HenrickRamalho/Holonomic-Robot-Swarm-Agent/Engine Speed Controller Design/Gráficos de Sintonia Controlador de Velocidade.xlsx

Sheet: Plan1
0
63
105
100
91
90
94
96
97
96
95
98 | float Kp = 0.95; //Ganho Proporcional
98 | float Ki = 0.35; //Ganho Integral
99
99
99
99
98
99
100
101
99
99
98
99
101
101
100
101
99
98
71
34
6
0
0
0
0
0
0
0
59
103
98
89
88
91
93
96
97
97
96
97
97
98
99
100
100
99
98
98
98
100
102
99
99
99
99
100
101
100
84
44
13
0
0
0
0
0
0
0
4
75
110
102
94
93
97
98
97
97
97
100
100
100
99
98
99
99
99
101
100
101
98
99
100
101
100
101
100
100
90
50
18
0
0
0
0
0
0
0
0
68
112
104
93
91
95
97
98
97
98
99
98
98
98
100
101
100
99
98
99
99
100
102
100
100
99
98
100
101
97
63
28
3
0
0

Sheet: Plan2
0
0
0
0
0
0
0
87
118
91
76
86
94
93
91 | float Kp = 1.50; //Ganho Proporcional
93 | float Ki = 0.35; //Ganho Integral
95
95
95
96
98
98
98
97
97
98
98
100
100
99
98
98
98
100
101
100
100
83
43
12
0
0
0
0
0
0
0
0
112
138
97
77
89
99
95
91
94
98
98
96
96
97
97
98
99
99
99
98
99
99
99
100
100
99
99
99
99
92
54
22
0
0
0
0
0
0
0
0
103
127
92
78
88
97
95
92
94
96
97
95
96
98
99
98
98
98
97
99
100
101
99
98
99
98
100
101
99
97
63
28
4
0
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
