HenrickRamalho/Holonomic-Robot-Swarm-Agent/Stl Files for 3d Printing/Travas Motores.stl

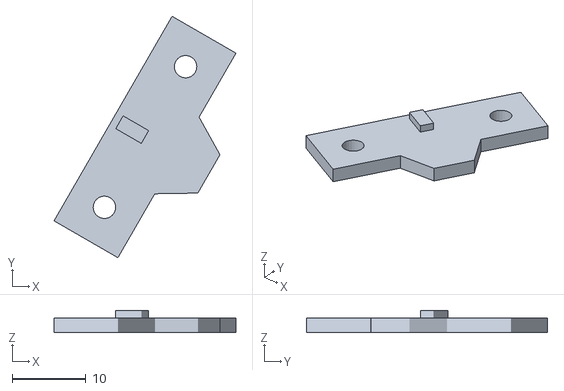
[picture p1: CAD file, 2020-04-10]
Stl Files for 3d Printing/Travas Motores.stl
24.7 x 32.7 x 3.00
