HenrickRamalho/Holonomic-Robot-Swarm-Agent/triangle_description/mesh/rim.stl

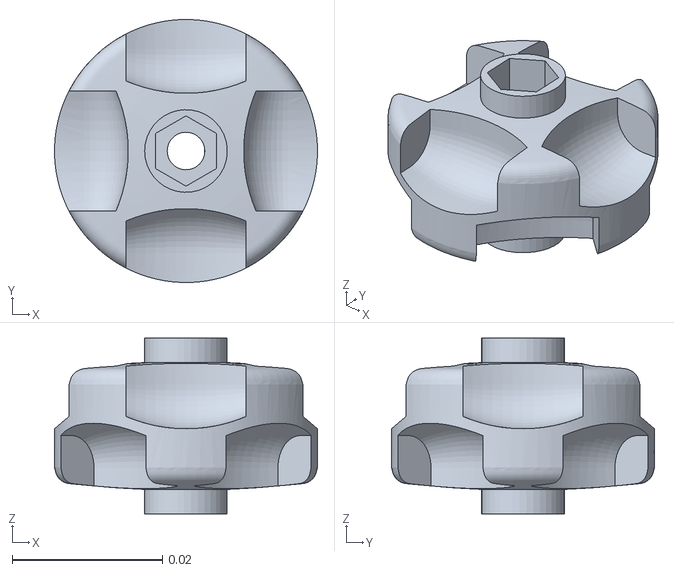
[picture p2: CAD file, 2020-03-14]
triangle_description/mesh/rim.stl
0.035 x 0.035 x 0.0234
