HenrickRamalho/Holonomic-Robot-Swarm-Agent/triangle_description/mesh/roller.stl

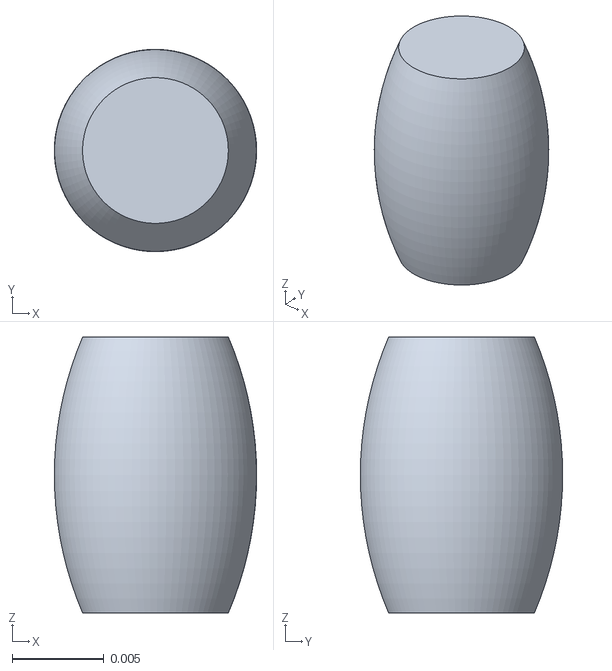
[picture p3: CAD file, 2020-03-14]
triangle_description/mesh/roller.stl
0.011 x 0.011 x 0.015
