HenrickRamalho/Holonomic-Robot-Swarm-Agent/Stl Files for 3d Printing/Acopladores Motor Roda.stl

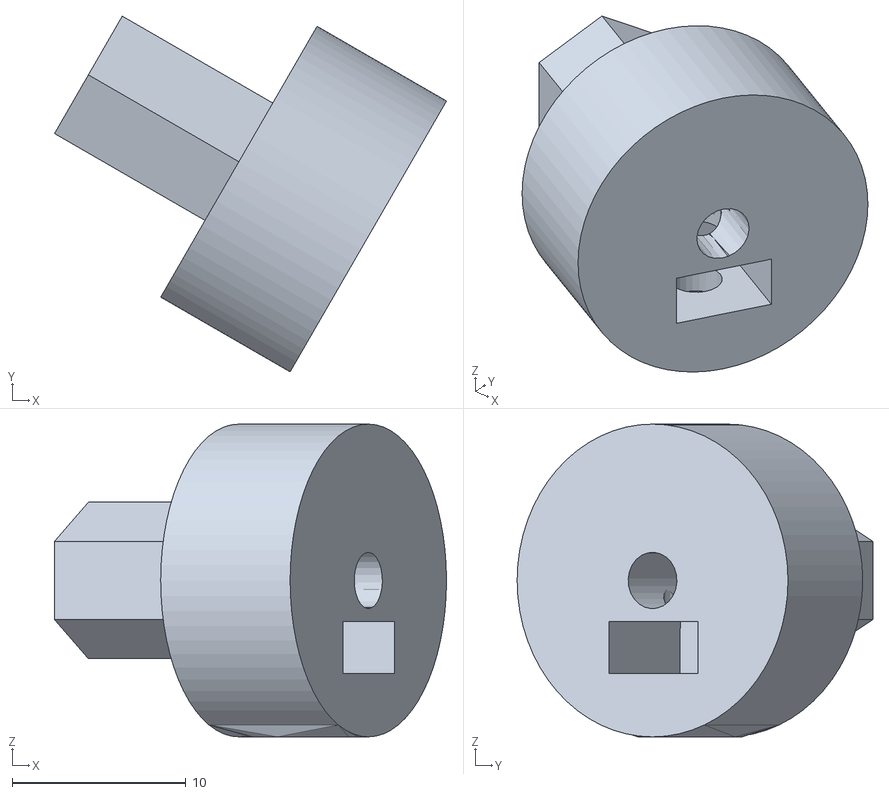
[picture p4: CAD file, 2020-04-10]
Stl Files for 3d Printing/Acopladores Motor Roda.stl
22.6 x 20.5 x 18.0
