HenrickRamalho/Holonomic-Robot-Swarm-Agent/triangle_description/mesh/base.stl

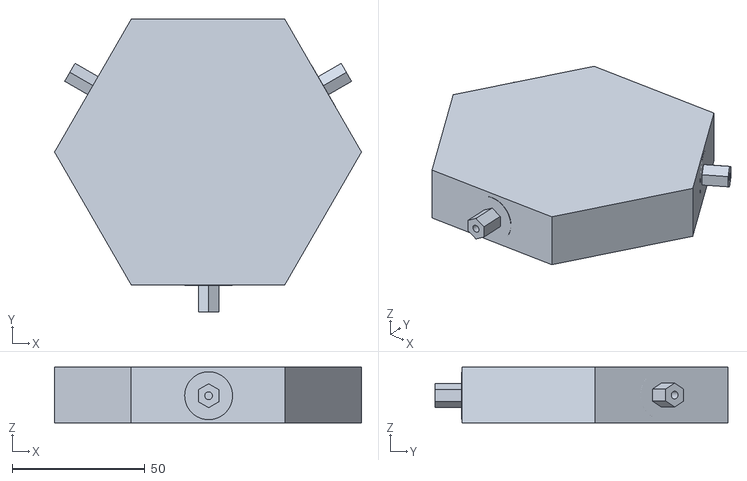
[picture p5: CAD file, 2020-03-14]
triangle_description/mesh/base.stl
115.5 x 110.1 x 21.0
