HenrickRamalho/Holonomic-Robot-Swarm-Agent/Stl Files for 3d Printing/Chassi Camera.stl

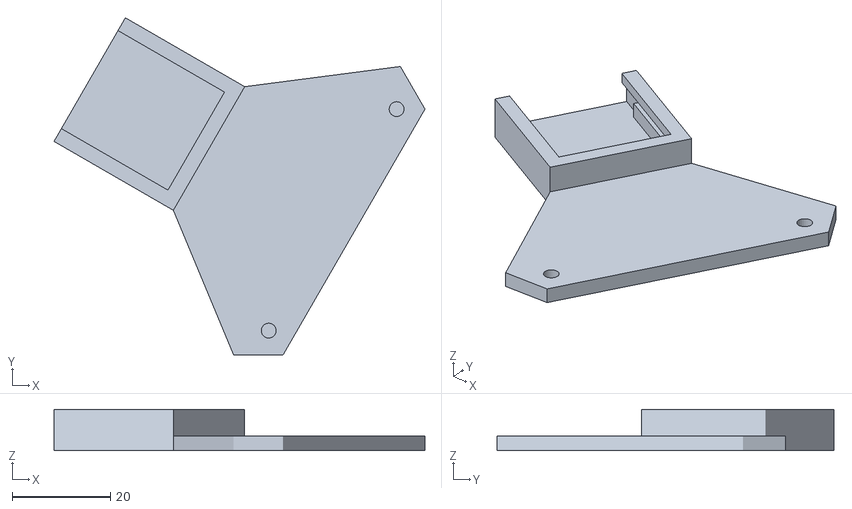
[picture p6: CAD file, 2020-04-10]
Stl Files for 3d Printing/Chassi Camera.stl
75.4 x 68.6 x 8.40
