HenrickRamalho/Holonomic-Robot-Swarm-Agent/Stl Files for 3d Printing/Chassi Motores.stl

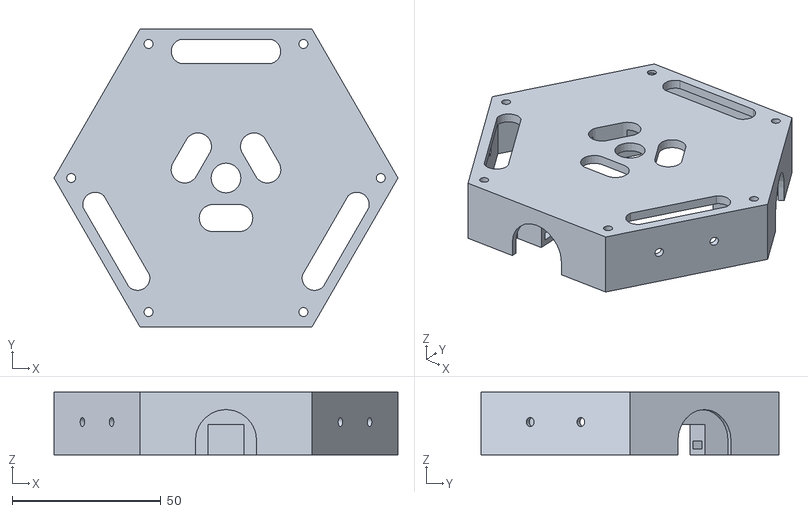
[picture p7: CAD file, 2020-04-10]
Stl Files for 3d Printing/Chassi Motores.stl
115.5 x 100.0 x 21.0
