HenrickRamalho/Holonomic-Robot-Swarm-Agent/Stl Files for 3d Printing/Chassi RaspberryPi.stl

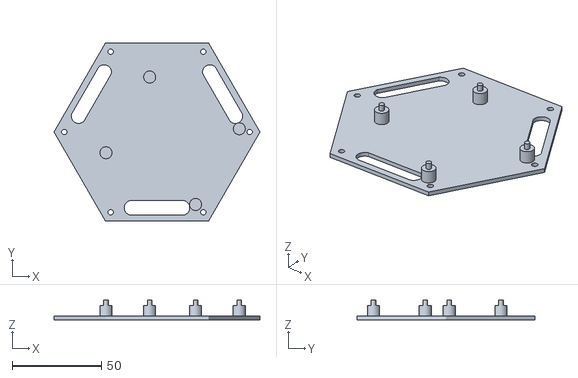
[picture p8: CAD file, 2020-04-10]
Stl Files for 3d Printing/Chassi RaspberryPi.stl
115.5 x 100.0 x 11.0
