HenrickRamalho/Holonomic-Robot-Swarm-Agent/(list of files, cad)

Other CAD files:
Stl Files for 3d Printing/Chassi Fonte.stl
