HenrickRamalho/Holonomic-Robot-Swarm-Agent/Engine Speed Controller Design/Speed_Controll_PCB.brd

## EAGLE design Engine Speed Controller Design/Speed_Controll_PCB.brd (2019-11-26)

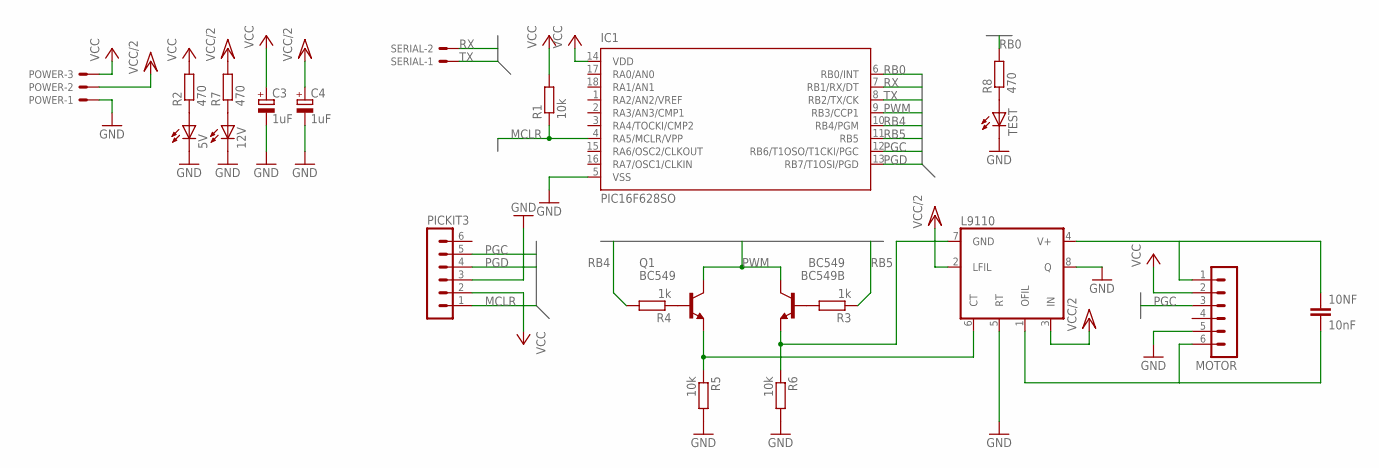
[picture p9: schematic Speed_Controll_PCB.sch]

Parts:
5V, 12V: LEDCHIPLED_1206; CHIPLED_1206
10NF: 10nF; C0603K
BC549: BC549B; TO92-EBC
C3, C4: 1uF; 153CLV-0405
IC1: PIC16F628SO; SO-18W
L9110: LM567D; SO08
MOTOR: MA06-1
PICKIT3: MA06-1
POWER: JST-XH-03-PIN-LONG-PAD; JST-XH-03-PACKAGE-LONG-PAD
Q1: BC549; TO92-EBC
R1, R5, R6: 10k; MINI_MELF-0102W
R2, R7, R8: 470; MINI_MELF-0102W
R3, R4: 1k; MINI_MELF-0102W
SERIAL: JST-XH-02-PIN-LONG-PAD; JST-XH-02-PACKAGE-LONG-PAD
TEST: LEDCHIPLED_1206; CHIPLED_1206

Connections:
GND: 5V.C, 12V.C, C3.-, C4.-, IC1.5 (VSS), L9110.5 (RT), L9110.8 (Q), MOTOR.5, PICKIT3.3, POWER.1, R5.2, R6.2, TEST.C
MCLR: IC1.4 (RA5/MCLR/VPP), PICKIT3.1, R1.1
unnamed: 10NF.1, L9110.4 (V+), MOTOR.1
unnamed: 5V.A, R2.1
unnamed: BC549.E, L9110.7 (GND), R6.1
unnamed: 10NF.2, L9110.1 (OFIL), MOTOR.6
unnamed: BC549.B, R3.2
unnamed: Q1.B, R4.1
unnamed: 12V.A, R7.1
unnamed: R8.1, TEST.A
unnamed: L9110.6 (CT), Q1.E, R5.1
PGC: IC1.12 (RB6/T1OSO/T1CKI/PGC), MOTOR.3, PICKIT3.5
PGD: IC1.13 (RB7/T1OSI/PGD), PICKIT3.4
PWM: BC549.C, IC1.9 (RB3/CCP1), Q1.C
RB0: IC1.6 (RB0/INT), R8.2
RB4: IC1.10 (RB4/PGM), R4.2
RB5: IC1.11 (RB5), R3.1
RX: IC1.7 (RB1/RX/DT), SERIAL.2
TX: IC1.8 (RB2/TX/CK), SERIAL.1
VCC: C3.+, IC1.14 (VDD), MOTOR.2, PICKIT3.2, POWER.3, R1.2, R2.2
VCC/2: C4.+, L9110.2 (LFIL), L9110.3 (IN), POWER.2, R7.2

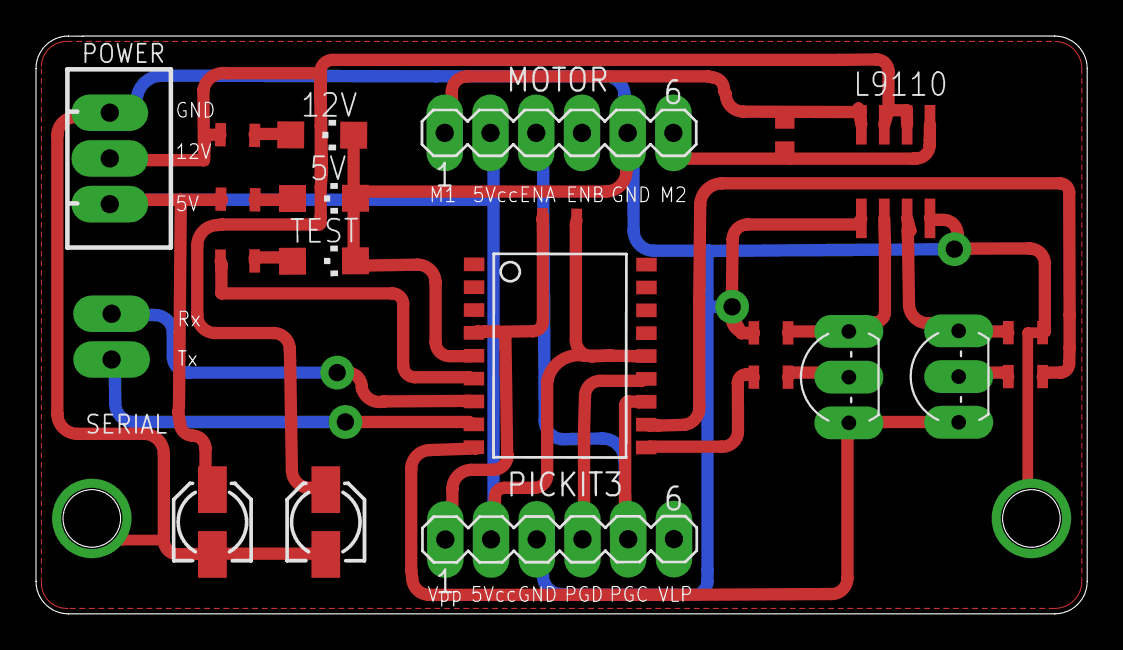
[picture p10: board Speed_Controll_PCB.brd from above]

Board: 2 copper layers, 58.4 x 32.1 mm, 22 parts (1 on the bottom side), 21 nets.
