HenrickRamalho/Holonomic-Robot-Swarm-Agent/Stl Files for 3d Printing/Robot.png

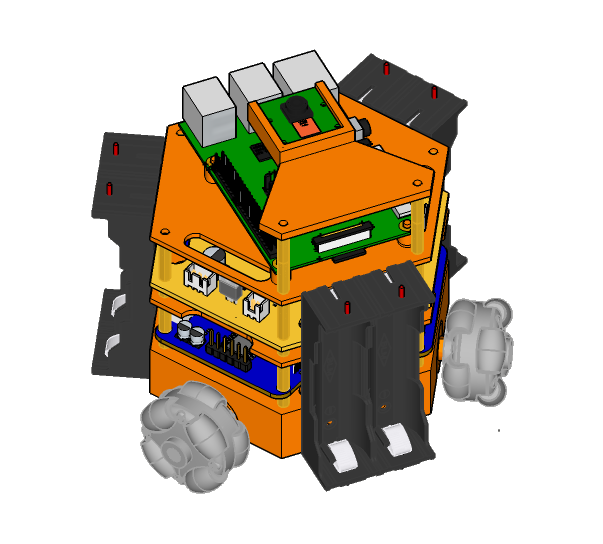
Stl Files for 3d Printing/Robot.png
