HenrickRamalho/Holonomic-Robot-Swarm-Agent/(threads)

Thread 2 (2020-02-05):

Fornecer modelo URDF do robô

hjudiss, 2020-02-05:
Talvez usando isso:
http://wiki.ros.org/Industrial/Tutorials/Create%20a%20URDF%20for%20an%20Industrial%20Robot

hjudiss, 2020-02-05:
O modelo pode ser feito ap3roveitando os arquivos STL que o @HenrickRamalho já disponibilizou. Faltariam ainda arquivos 3D de outros itens, principalmente a roda.
Também achei o seguinte repositório em que podemos no basear.
https://github.com/GuiRitter/OpenBase
@HenrickRamalho você poderia confirmar se o modelo da roda é equivalente?

HenrickRamalho, 2020-02-06:
Sim professor, esse modelo da roda é igual.

Em qua, 5 de fev de 2020 20:01, Heitor Savino <notifications@github.com>
escreveu:

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

hjudiss, 2020-02-06:
ótimo, vou criar um esqueleto de um pacote a partir dele entao.
Você poderia olhar os outros itens que marquei em
https://github.com/HenrickRamalho/Holonomic-Robot-Swarm-Agent/issues/2#issuecomment-582654639
?

hjudiss, 2020-02-26:
você poderia carregar os .stf na pasta: https://github.com/HenrickRamalho/Holonomic-Robot-Swarm-Agent/tree/master/Stl%20Files%20for%203d%20Printing?

hjudiss, 2020-04-09:
@HenrickRamalho você pode me enviar ou carregar os arquivos stl separadamente de cada parte que voce usou para montar o robô completo?

hjudiss, 2020-05-04:
@HenrickRamalho qual a altura das hastes que separam as placas na vertical? tem uma baixinha e outras maiores, certo? quais as medidas?

Thread 3 (2020-02-05):

Carregar o modelo em Gazebo com as interfaces de controle

hjudiss, 2020-02-05:

hjudiss, 2020-02-26:
Estou cuidando desta parte. Vou precisar que o robô tenha as interfaces de velocidade funcionando para que o sistema seja transparente entre simulação e o robô real.

Closed 2020-04-23.

Thread 5 (2020-03-11):

Separação de tarefas entre os agentes

HenrickRamalho, 2020-03-11:
Desenvolvi um arquivo launch para realizar a separação de tarefas entre os robôs, agora as câmeras estão trabalhando de forma individual; a imagem a seguir mostra o arquivo de launch do robô master na rede:

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

a seguir temos o arquivo de launch do robô escravo:

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

o rqt_graph de execução do ROS:

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

as câmeras acionadas no hardware:

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

Agora vamos para os problemas:
                   *Aparentemente a localização parou de funcionar, o rviz fica alternando entre as
                    câmeras dos robôs;
                   *A mensagem de localização gerada pelo Slam agora é essa:

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

Acredito que quando for sanado este problema, os robôs poderão executar suas tarefas em conjunto.

hjudiss, 2020-03-11:
Eu acredito que ainda deve haver um fiducial_slam pra cada robô.
Os dois agentes estão enviando dados para esse nó num mesmo tópico

HenrickRamalho, 2020-03-11:
Fiz a modificação do Slam, mas o tópico Fiducial_transforms também precisa ser modificado, pois o mesmo esta sendo enviado pelo robo02 (slave) para o slam do robo01 (master).

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

hjudiss, 2020-03-11:
você pode renomear os tópicos com qualquer nome. Mas o padrão seria incluir também o namespace no tópico.

HenrickRamalho, 2020-03-11:
Certo, estou testando se o fiducial_transforms pode ser alterado por um argumento.

hjudiss, 2020-03-12:
quando você faz o launch você pode colocar ele em um namespace, assim como
os tópicos

On Thu, Mar 12, 2020 at 12:25 AM HenrickRamalho <notifications@github.com>
wrote:

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

--
Heitor J. Savino

hjudiss, 2020-04-03:
@HenrickRamalho você conseguiu resolver isso?

Thread 6 (2020-04-09):

detalhes de materiais

hjudiss, 2020-04-09:
Olá @HenrickRamalho

qual o material usado para imprimir as partes?
estou especificamente interessado no peso e nas densidades

hjudiss, 2020-04-09:
@HenrickRamalho
você tem como pesar a base do robô pra mim junto com os motores e controladores?

HenrickRamalho, 2020-04-09:
Tenho sim

Em qui, 9 de abr de 2020 10:43, Heitor Savino <notifications@github.com>
escreveu:

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

HenrickRamalho, 2020-04-09:
Ele tem 623 gramas, completo.

Em qui, 9 de abr de 2020 10:43, Henrick Ramalho <henrickviana@gmail.com>
escreveu:

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

hjudiss, 2020-04-09:
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
essa parte sem a roda dá 623?

HenrickRamalho, 2020-04-09:
Não, esse era o peso total, do robô inteiro, vou fazer a leitura novamente.

Em qui, 9 de abr de 2020 11:01, Heitor Savino <notifications@github.com>
escreveu:

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

HenrickRamalho, 2020-04-10:
Olá professor, o peso medido da parte inferior do robô incluindo:
- Chassi Inferior (Onde os motores são fixados);
- 3 Travas para os motores;
- 3 Acopladores Motor/Roda;
- 3 Motores com Encoder;
- 3 Placas de Controle de Velocidade;
- 3 Cabos 6 vias que ligam Motor/Controlador;
- 6 parafusos e porcas;
Foi igual a 135 gramas.

Thread 7 (2020-04-23):

Sugestões de capítulos e seções

hjudiss, 2020-04-23:
Podemos sugerir aqui a sequencia do trabalho de dissertação:
Na qualificação havia:

1. INTRODUÇÃO
2. FUNDAMENTAÇÃO TEÓRICA
2.1 Robôs Omnidirecionais
2.2 Controle Preditivo
2.3 Particle Swarm Optimization
3 OBJETIVOS GERAL E ESPECÍFICO
3.1 Objetivo Geral
3.2 Objetivos Específicos
4. RELEVÂNCIA DA PROPOSTA
5. METODOLOGIA
6. CRONOGRAMA DE ATIVIDADES
REFERÊNCIAS

Posso pensar nas seguintes partes, a desenvolver mais:

1. INTRODUÇÃO
2. FUNDAMENTAÇÃO TEÓRICA
2.1 Robôs Omnidirecionais
2.2 Particle Swarm Optimization
2.3 OBJETIVOS GERAL E ESPECÍFICO
2.4 RELEVÂNCIA DA PROPOSTA
3. PROJETO DE HARDWARE
4. PROJETO DE SOFTWARE
5. SIMULAÇÃO
6. RESULTADOS EXPERIMENTAIS
REFERÊNCIAS

O que sugerem?

erickIC, 2020-04-23:
Sugiro o seguinte:
    1. INTRODUÇÃO
        1.1. Justificativa
        1.2. OBJETIVOS GERAL E ESPECÍFICO
        1.3. RELEVÂNCIA DA PROPOSTA
    2. FUNDAMENTAÇÃO TEÓRICA
        2.1. Robôs Omnidirecionais
        2.2. Enxame de robôs
        2.3. Plataforma de robôs omnidirecionais e para enxame
    3. PROJETO DE HARDWARE
        3.1. Controle das rodas
        3.2. Câmera
        3.3. Controle de velocidade e processamento principal
        3.4. Custo do hardware
    4. INTEGRAÇÃO COM O ROS
    5. SIMULAÇÃO (teve?)
    6. RESULTADOS EXPERIMENTAIS
    7. REFERÊNCIAS

**Justificativa**
- Removi “2.2. Particle Swarm Optimization” pois não terá mais a utilização do PSO
- Coloquei os objetivos e relevância na INTRODUÇÃO pois acho que devem estar logo no começo do texto
- Coloquei duas novas seções da FUNDAMENTAÇÃO TEÓRICA, a 2.3 é importantíssima para destacar as “concorrentes”
- Tentei colocar subseções em PROJETO DE HARDWARE seguindo os “andares” do robô
- Acho melhor colocar INTEGRAÇÃO COM O ROS em vez de PROJETO DE SOFTWARE, chama logo a atenção a isso no sumário
- Não lembro de resultados simulados

hjudiss, 2020-04-23:
De acordo com todas as sugestões.

> * Não lembro de resultados simulados
Vai ser a parte do simulador no Gazebo que estou finalizando. Eu vou me encarregar dessa parte

HenrickRamalho, 2020-04-23:
Muito bom! Estou de acordo.

hjudiss, 2020-04-23:
Adicionei as seções no documento do overleaf. Falta o @HenrickRamalho aceitar o convite enviado ao email: henrickviana@gmail.com

HenrickRamalho, 2020-04-23:
Caraca, mestres Jedis serão meus avaliadores !!!

Em qui., 23 de abr. de 2020 às 18:07, Heitor Savino <
notifications@github.com> escreveu:

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

hjudiss, 2020-04-23:
hahahaha! eu alterei os orientador e coorientador originais, que eram:
\orientador{Obi-Wan Kenobi}	%%Nome
\tituloOrientador{Prof. Dr.}
\coorientador{Darth Vader}%%Nome
\tituloCoorientador{Prof. Dr.}

HenrickRamalho, 2020-04-23:
kkkkkkkkkkk

Em qui., 23 de abr. de 2020 às 18:14, Heitor Savino <
notifications@github.com> escreveu:

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

Closed 2020-04-29.

Thread 8 (2020-04-23):

Sugestão de nome pro robô

hjudiss, 2020-04-23:
@HenrickRamalho , já tem nome pro robô?
Eu queria sugerir Omnino :smiley:
uma mistura de ô menino, com omni, e ainda soa italiano.
Vocês tem outras sugestões?
quando definirmos o nome adicionar a plataforma de simulacao no repositório do EASY

erickIC, 2020-04-23:
Omnino!!!!!
Kkkk
Nome chiclete, todo mundo vai pegar fácil.

Em qui, 23 de abr de 2020 14:42, Heitor Savino <notifications@github.com>
escreveu:

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

HenrickRamalho, 2020-04-23:
Também gostei professor! Está ótimo!

Closed 2020-05-01.

Thread 10 (2020-04-24):

escrita do artigo

hjudiss, 2020-04-24:
posso também dar a seguinte indicação de congresso:

hjudiss, 2020-04-24:
Topics |
Robotics at school
Robotics teachers formation
Robotics competitions
**Educational Robotics Platform**
Robotics in informal teaching (extra class)
Study cases
Methodologies and materials for teaching
Web based Robotics Educational
Robotics Simulation
Robotics in Education curricula
**Low cost educational robots**
Social robotics
Unplugged Robotics
Computational thinking with Educational Robotics
Robot-student interaction
STEM with Robotics based projects
Problem based learning with Robotics
Robot-student interaction
* Please choose between 1 and 3 topics

hjudiss, 2020-04-24:
submissão está aberta e deadline de 15 de junho

hjudiss, 2020-05-04:
Computers and Electrical Engineering
https://www.journals.elsevier.com/computers-and-electrical-engineering/

Journal of Control, Automation and Electrical Systems
https://link.springer.com/journal/40313/volumes-and-issues

Thread 11 (2020-04-30):

Custo

hjudiss, 2020-04-30:
@HenrickRamalho, coloque aqui a lista de custos, por favor.

HenrickRamalho, 2020-04-30:
Para a montagem de um Omnino são necessários os seguintes materiais:

     - 3 rodas omnidirecionais 1,5 pol ou 38mm -  Custo R$76,20
     - 3 motores N20 6Vcc 90RPM com encoder - Custo R$95,82
     - 3 Cases de bateria 18650 2 slots - Custo R$11,31
     - 6 baterias 18650 recarregáveis R$34,70
     - 1 Raspberry Pi 3 Model B+ - Custo R$262,08
     - 1 Raspicam 1080p 720p 5mp - Custo R$21,02
     - Peças impressas em 3D - Custo R$50,00
     - 3 placas de controle de velocidade - Custo R$60,00
     - 1 placa de fonte - Custo R$19,00
     - Parafusos e Porcas - Custo R$15,00
     * Custo total =R$645,13
A maior parte dos valores ficaram mais altos por conta do aumento do dólar.

hjudiss, 2020-05-01:
pode colocar o valor em dólar

hjudiss, 2020-05-01:
>  1 Raspicam 1080p 720p 5mp - Custo R$21,02

camera tem realmente esse preço?

HenrickRamalho, 2020-05-01:
Sim professor!

Em sex, 1 de mai de 2020 18:16, Heitor Savino <notifications@github.com>
escreveu:

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

Thread 12 (2020-04-30):

é possível imprimir a roda? e outros?

hjudiss, 2020-04-30:
@HenrickRamalho a roda você comprou, seria possível imprimir?

favor, listar tudo o que foi comprado e o que pode ser impresso

HenrickRamalho, 2020-04-30:
Sim professor, as rodas foram compradas, mas posso tentar fazer os arquivos de impressão delas.

HenrickRamalho, 2020-04-30:
Também podemos imprimir os packs de baterias, mas eles são tão baratos, por volta de 3 reais, que ficam mais caros se forem impressos em 3D.

hjudiss, 2020-04-30:
> Sim professor, as rodas foram compradas, mas posso tentar fazer os arquivos de impressão delas.

Veja só se tem algum modelo feito já. Se houver você inclui

Closed 2020-04-30.

Thread 13 (2020-04-30):

eletronica

hjudiss, 2020-04-30:
@HenrickRamalho as placas de controle dos motores foram feitas por você também?

Favor identificar tudo o que pode ser fabricado e tudo o que deve ser comprado aqui:

HenrickRamalho, 2020-04-30:
Sim as placas de controle de velocidade e fonte foram desenvolvidas e confeccionadas por mim, mas nos robôs finais mandei a confecção das PCB's de controle para ser executada na China, recebendo as placas vindas da China, tive que somente soldar os componentes e programar o microcontrolador PIC que nela se encontra.

Para a confecção das placas de controle de velocidade são necessários:
     - 3 placas de fenolite dupla face virgem (3,2cm x 5,7cm)
     - 3 microcontroladores PIC16f628A em SMD-SOP
     - 6 Transistores BC549 TO-92
     - 9 Led's SMD 0805
     - 6 capacitores eletrolíticos 10uF 16Vcc SMD
     - 9 resistores 470 Ohm 0805
     - 9 resistores de 10k Ohm 0805
     - 6 resistores de 4,7k Ohm 0805
     - 3 Capacitores Cerâmicos 1nF SMD 0603
     - 3 CI ponte H 9110 SMD
     - 3 conectores Header Macho 6 vias
     - 3 conectores JST Fêmea 6 vias
     - 3 conectores JST Fêmea 3 vias
     - 3 conectores JST Fêmea 2 vias

Placa totalmente feita por mim:
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

Placa confeccionada na China:
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

Placa chinesa com montagem e soldagem minha:
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

hjudiss, 2020-04-30:
Inclua também uma foto do esquemático, se possível. To pensando em como colocar isso na seção de Hardware, talvez o @erickIC saiba melhores formas de descrever a essa parte de hardware.

erickIC, 2020-04-30:
Para descrever o HW coloque o esquemático elétrico e a placa pronta. Além de no texto colocar uma tabela, ou lista, com todos os componentes. Talvez isso possa até ser um apêndice, para não poluir muito o texto.

hjudiss, 2020-05-01:
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
Que tal uma imagem nesse mesmo sentido?

HenrickRamalho, 2020-05-01:
Achei muito boa professor!
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

hjudiss, 2020-05-01:
A bateria é de apenas 400mAh?
A rede de comunicação já é fornecida na própria Raspberry?

HenrickRamalho, 2020-05-01:
No desenho cometi um erro, as baterias tem 980mah, e a comunicação é feita pela rede gerada pelo próprio raspberry, eles se comunicam por wifi.

Segue o desenho atualizado:
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

HenrickRamalho, 2020-05-01:
Fiz este com a indicação da comunicação wifi:
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

hjudiss, 2020-05-01:
Coloca Video Stream em vez de Localization

Em sex., 1 de mai. de 2020 às 16:49, HenrickRamalho <
notifications@github.com> escreveu:

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

--
Heitor J. Savino

HenrickRamalho, 2020-05-01:
Modificação feita!

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

hjudiss, 2020-05-01:
de qualquer forma, o esquemático que você mostrou anteriormente vai entrar
na dissertação. No artigo vamos limitar a esse mais simples.

Faz uma versão alternativa:
remove o título Omnino Hardware Diagram, pois eu posso colocar isso na
leganda da figura.
Tira o contorno e coloca o fundo branco, ou transparente (se possível).

Em sex., 1 de mai. de 2020 às 17:21, HenrickRamalho <
notifications@github.com> escreveu:

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

--
Heitor J. Savino

HenrickRamalho, 2020-05-01:
Não tenho certeza se o fundo ficou transparente, segue o aquivo:
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

HenrickRamalho, 2020-05-01:
Acho que ficou!

hjudiss, 2020-05-01:
ficou boa.
ainda acho 980mAh muito pouco comparado com outras que eu vi

HenrickRamalho, 2020-05-01:
verdade, posso ver baterias melhores para o projeto, essas baterias são bem fraquinhas, pois seu custo é muito baixo,

erickIC, 2020-05-04:
Ficou bom!

Em sex., 1 de mai. de 2020 às 17:16, HenrickRamalho <
notifications@github.com> escreveu:

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

--

[image: Universidade Federal de Alagoas] <http://www.ufal.br/>

Erick de Andrade Barboza / Professor Dr.
Lattes <http://lattes.cnpq.br/1049532071774598>

Universidade Federal de Alagoas
Instituto de Computação - IC
www.ufal.br

[image: Twitter]  <https://www.twitter.com/ufaloficial> [image: Facebook]
<https://www.facebook.com/ufaloficial> [image: Instagram]
<https://www.instagram.com/ufaloficial> [image: Youtube]
<https://www.youtube.com/user/AscomUfal> [image: Flickr]
<https://www.flickr.com/photos/ufaloficial/> [image: Soundcloud]
<https://soundcloud.com/ufaloficial>
*"Venham a mim, todos os que estão cansados e sobrecarregados, e eu lhes
darei descanso." (Mateus 11:28
<https://www.bibliaonline.com.br/nvi/mt/11/28>)*

Thread 14 (2020-05-02):

Gráficos de Deslocamento Omnino

HenrickRamalho, 2020-05-02:

HenrickRamalho, 2020-05-02:
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

hjudiss, 2020-05-02:
tempo ou amostras?

Em sáb., 2 de mai. de 2020 às 22:46, HenrickRamalho <
notifications@github.com> escreveu:

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

HenrickRamalho, 2020-05-02:
Amostras, corrigido!

hjudiss, 2020-05-02:
Podemos dispensar o eixo z do segundo gráfico, já que só controlamos no plano. Você está plotando diretamente do python?

HenrickRamalho, 2020-05-02:
Isso, estou usando matplotlib.

hjudiss, 2020-05-02:
Tem alguma opção de exportar os dados pra algum formato do matlab?

Em sáb., 2 de mai. de 2020 às 22:59, HenrickRamalho <
notifications@github.com> escreveu:

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

--
Heitor J. Savino

HenrickRamalho, 2020-05-02:
acredito que sim! vou ver se posso gerar um arquivo com estes dados.

HenrickRamalho, 2020-05-02:
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
[Plot_x.txt](https://github.com/HenrickRamalho/Holonomic-Robot-Swarm-Agent/files/4568988/Plot_x.txt)
[Plot_y.txt](https://github.com/HenrickRamalho/Holonomic-Robot-Swarm-Agent/files/4568989/Plot_y.txt)

Pode ser assim professor?

hjudiss, 2020-05-02:
não consegui do jeito que está pq os dados estão juntos. Se você separar
com espaço ou vírgula eu consigo extrair os dados sim.

Em sáb., 2 de mai. de 2020 às 23:35, HenrickRamalho <
notifications@github.com> escreveu:

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

--
Heitor J. Savino

HenrickRamalho, 2020-05-02:
Pronto, dei um enter entre os dados

[Plot_x.txt](https://github.com/HenrickRamalho/Holonomic-Robot-Swarm-Agent/files/4569147/Plot_x.txt)
[Plot_y.txt](https://github.com/HenrickRamalho/Holonomic-Robot-Swarm-Agent/files/4569148/Plot_y.txt)
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

HenrickRamalho, 2020-05-02:
A localização não esta muito boa por conta da iluminação, isso dificulta a leitura da tag aruco.

hjudiss, 2020-05-02:
Tenta colocar a lanterna do celular apontando pra cima. Ou é luz demais no
teto?

Em dom, 3 de mai de 2020 00:06, HenrickRamalho <notifications@github.com>
escreveu:

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

HenrickRamalho, 2020-05-02:
Vou fazer isso.

HenrickRamalho, 2020-05-03:
Bom dia professor! Devo manter esses gráficos ou somente crio os arquivos com os dados ou os dois? kkkk

hjudiss, 2020-05-03:
Pode fazer os dois. Mas com certeza ele vai sofrer ajustes :D

Em dom., 3 de mai. de 2020 às 14:35, HenrickRamalho <
notifications@github.com> escreveu:

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

--
Heitor J. Savino

HenrickRamalho, 2020-05-03:
Professor, essa imagem é mais recente do robô,  vi que na do artigo a segunda imagem é com raspberry pi zero w.

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

hjudiss, 2020-05-03:
inclui uma imagem como essa só que nível a nível.
ex, só com a primeiro nível do controlador,
depois outra incluindo o outro nível, da parte de potência?
depois a outra incluindo a rasp,
e essa também, que já tá pronta.
envia cada uma dessas individualmente

Em seg., 4 de mai. de 2020 às 00:11, HenrickRamalho <
notifications@github.com> escreveu:

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

--
Heitor J. Savino

HenrickRamalho, 2020-05-03:
Certo, vou fazer isso!

HenrickRamalho, 2020-05-04:
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

Thread 15 (2020-05-05):

Definição do experimento

hjudiss, 2020-05-05:
Definimos que vamos usar:
1- o gráfico de um agente atingido a posição de referência
2- três agentes mantendo formação em triângulo aplicando consenso
3- simulação com um número maior de agentes

hjudiss, 2020-05-05:
@HenrickRamalho as posições dos agentes estão num referencial global?

HenrickRamalho, 2020-05-05:
Sim, pois utilizei o mesmo mapa do slam gerado pelo Fiducials em todos eles.

HenrickRamalho, 2020-05-05:
As câmeras também foram calibradas, para dar maior confiabilidade a localização.

hjudiss, 2020-05-05:
Vou anexar umas imagens e logo definimos o grafo e as posições

hjudiss, 2020-05-05:
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

hjudiss, 2020-05-05:
u_i seria o comando de velocidade dos agentes que seguem o líder
e podemos fazer uma topologia de rede assim:
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

hjudiss, 2020-05-05:
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

e você pode definir,
x1*=0, y1*=0
x2*=0.2, y2*=0
x3*=0.1, y3*=0.17
isso forma um triângulo equilátero de lado 0.2 cm

hjudiss, 2020-05-05:
no caso teríamos:

vx1 = operador
vy1 = operador

vx2 = (x1* - x1) + 2*(x2* - x2) + (x3* - x3)
vy2 = (y1* - y1) + 2*(y2* - y2) + (y3* - y3)

vx3 = (x1* - x1) + (x2* - x2) + 2*(x3* - x3)
vy3 = (y1* - y1) + (y2* - y2) + 2*(y3* - y3)

hjudiss, 2020-05-05:
Como resultado espero ver um gráfico seguindo essa linha:

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

HenrickRamalho, 2020-05-05:
Que legal professor, estou fazendo o programa de distribuição das posições, pelo que entendi todos devem ter as posições de todos. É isso?

hjudiss, 2020-05-05:
Pra essa topologia sim. Todos as arestas direcionadas chegando a um agente
indicam que eles devem receber a informação do agente.
Pode ser feito de duas formas:
1. todos os agentes conhecem todos os xi*, recebem as posições dos
vizinhos, e localmente calculam os xi*-xi.
ou
2. recebem a medida de erro (xi*-xi) de cada vizinho, e conhecem só o seu x*

se puder implementar o 2, é mais eficiente

HenrickRamalho, 2020-05-05:
Entendi, vou fazer isso!
Vou fazer o dois, recebendo os erros de cada coordenada.
Obrigado professor!

Thread 16 (2020-07-05):

Sintonização PID Ziegler/Nichols Controlador de Velocidade

HenrickRamalho, 2020-07-05:
Olá professor,
para a sintonia do PID do controlador de velocidade, utilizei o método de malha aberta, pois a resposta do motor ao degrau demonstrou uma curva sigmoidal, o que possibilita este tipo de aplicação de sintonia.

Resposta ao degrau:
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

Em seguida apliquei a técnica de Ziegler/Nichols:
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

Após a implementação dos valores de Kp, Ki e Kd, o sistema infelizmente ofereceu uma resposta com bastante oscilação:
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

Sendo necessária a utilização da técnica de tentativa e erro:
Kp= (Kpz * 4)
Ki = (Kiz * 1)
Kd = (Kz * 4)
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

Kp= (Kpz * 4)
Ki = (Kiz * 0.5)
Kd = (Kz * 4)
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

Kp= (Kpz * 10)
Ki = (Kiz * 0.7)
Kd = (Kz * 4)
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

Acredito que a saída esta bastante otimizada.
