HenrickRamalho/Holonomic-Robot-Swarm-Agent/(commit log)

2019-11-26 Create Motor Speed Controller
2020-02-18 Create STL File For Gazebo Simulation
2020-03-14 Adicionando Triangle Description Package
    [base.stl, rim.stl, rim.urdf.xacro, roller.stl, roller.urdf.xacro, triangle.xacro]
